derexcz/co2-monitor-pocket-esp32c3/enclosure/stl/co2_monitor_base.stl

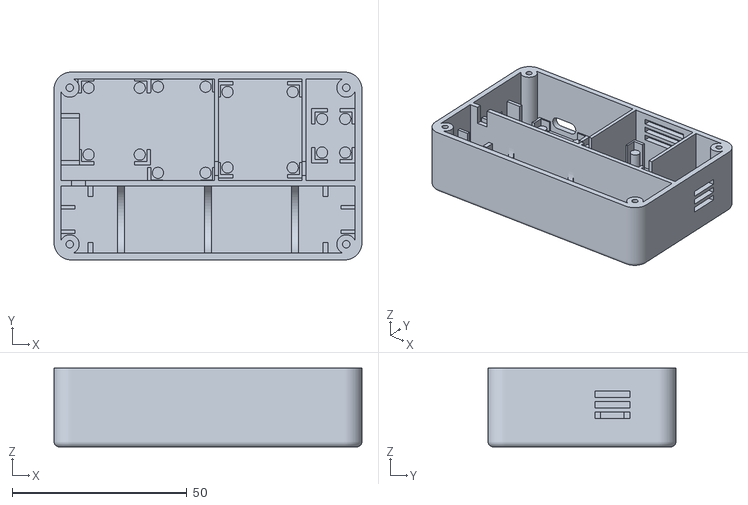
[picture p14: CAD file, 2026-10-12]
enclosure/stl/co2_monitor_base.stl
88.0 x 53.7 x 22.5
